jinchiyu/nove-macropad/kit/guides/macropad-full-schematic.png

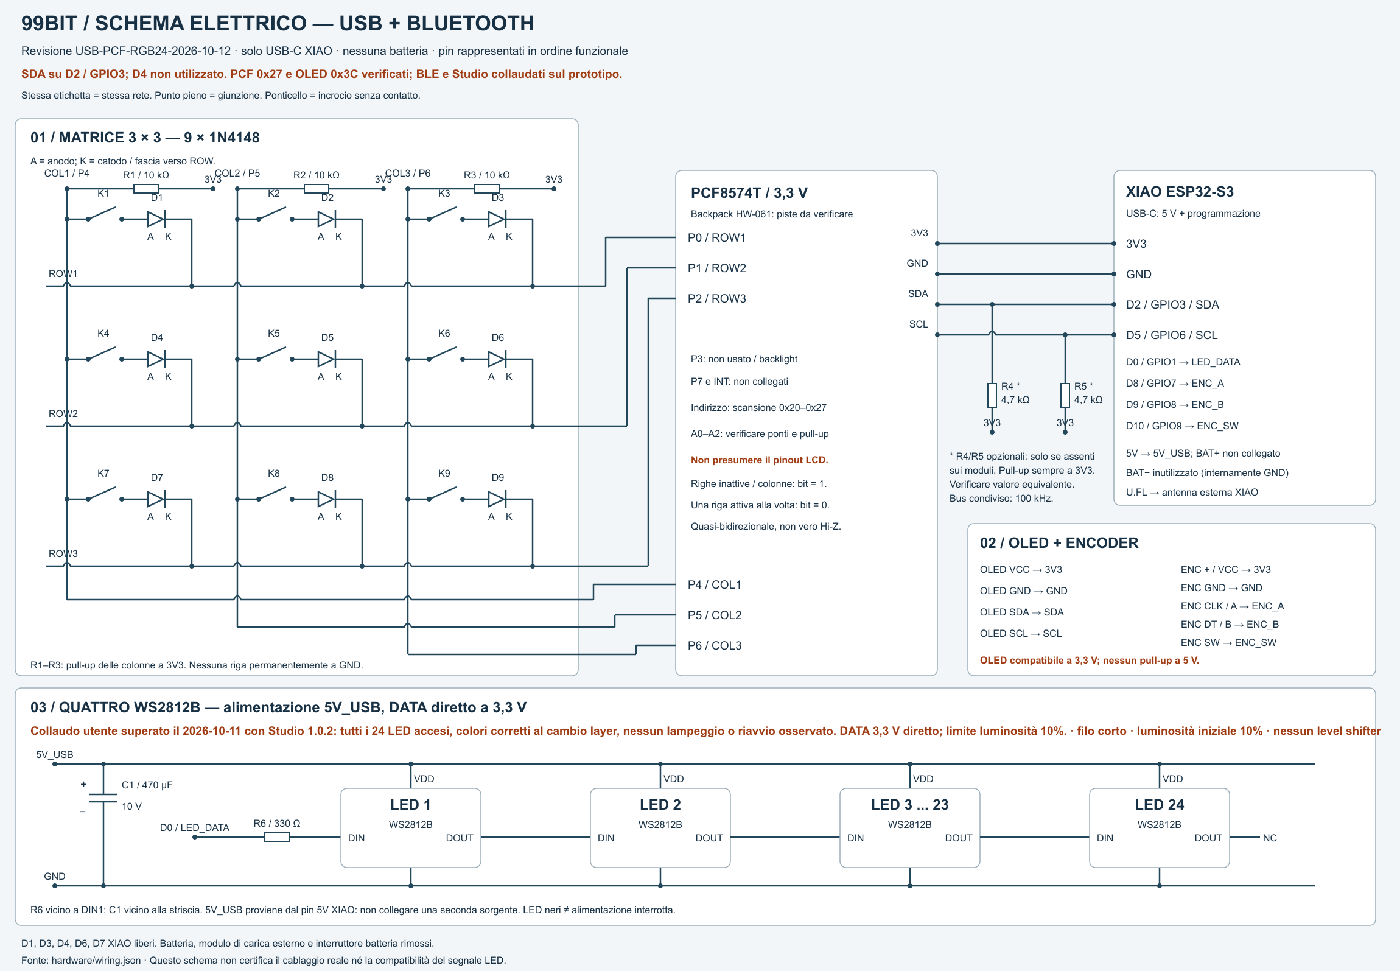
kit/guides/macropad-full-schematic.png
