jinchiyu/nove-macropad/kit/3MF/99BIT-V29-K1C-All-Plates.3mf

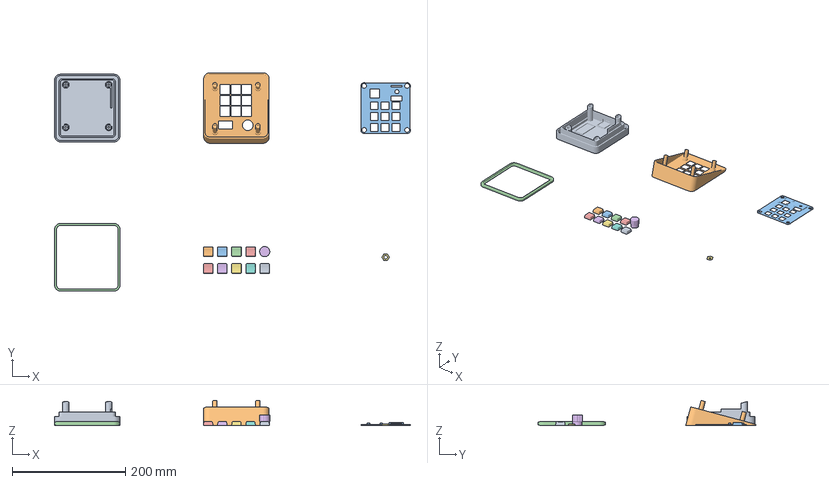
[picture p2: CAD file, 2026-10-12]
kit/3MF/99BIT-V29-K1C-All-Plates.3mf
630.0 x 386.4 x 44.6 mm
01-base.stl
02-shell.stl
03-control-plate.stl
04-diffuser.stl
05-keycap-1.stl
05-keycap-2.stl
05-keycap-3.stl
05-keycap-4.stl
05-keycap-5.stl
05-keycap-6.stl
05-keycap-7.stl
05-keycap-8.stl
05-keycap-9.stl
06-knob-extended.stl
07-encoder-nut.stl
