jinchiyu/nove-macropad/kit/3MF/02-shell-black.3mf

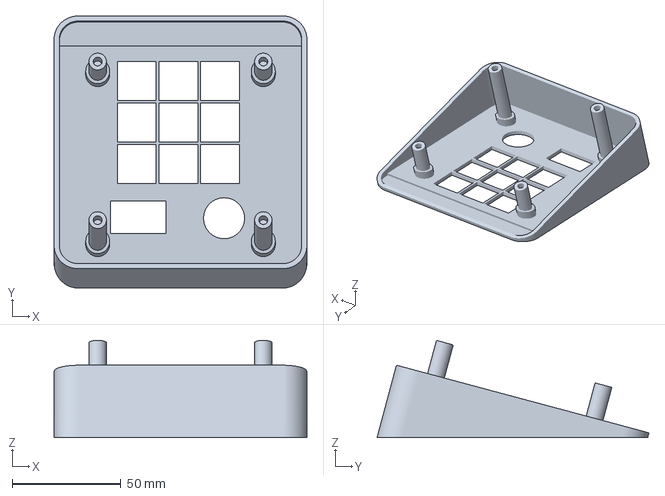
[picture p3: CAD file, 2026-10-12]
kit/3MF/02-shell-black.3mf
116.0 x 124.8 x 44.6 mm
