jinchiyu/nove-macropad/kit/STL/05-keycap-6.stl

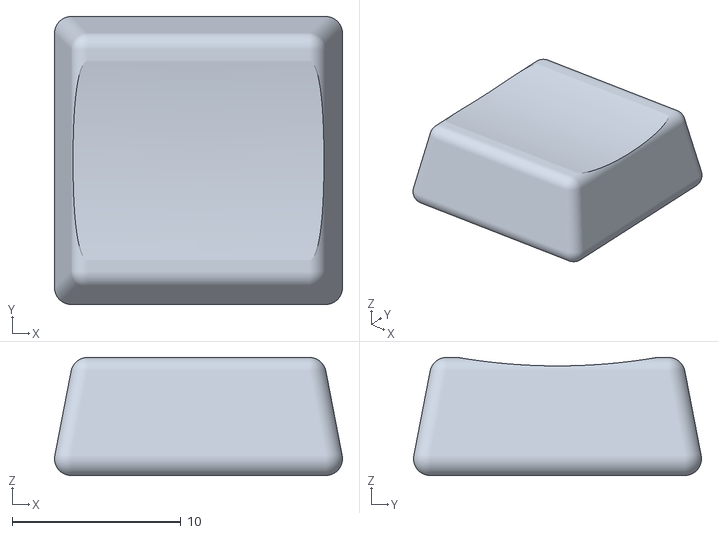
[picture p4: CAD file, 2026-10-12]
kit/STL/05-keycap-6.stl
17.1 x 17.1 x 7.00
