jinchiyu/nove-macropad/kit/3MF/05-keycaps-and-knob-translucent.3mf

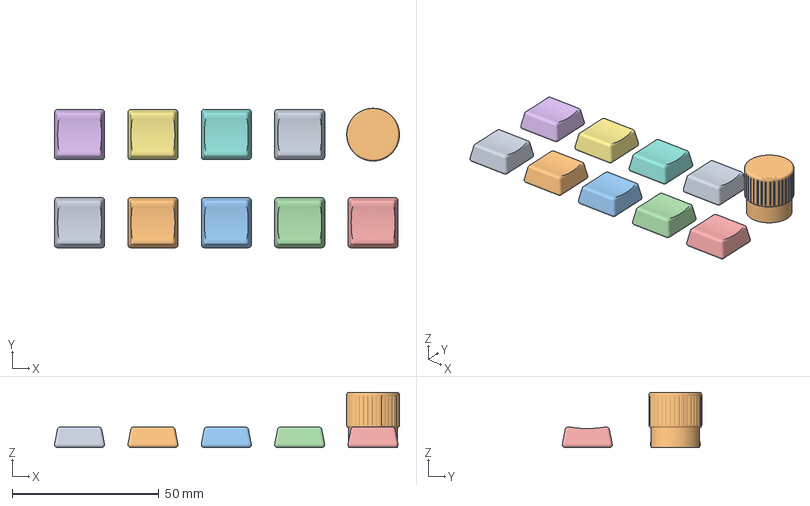
[picture p5: CAD file, 2026-10-12]
kit/3MF/05-keycaps-and-knob-translucent.3mf
117.5 x 47.5 x 18.8 mm
05-keycap-1.stl
05-keycap-2.stl
05-keycap-3.stl
05-keycap-4.stl
05-keycap-5.stl
05-keycap-6.stl
05-keycap-7.stl
05-keycap-8.stl
05-keycap-9.stl
06-knob-extended.stl
