jinchiyu/nove-macropad/kit/STL/01-base.stl

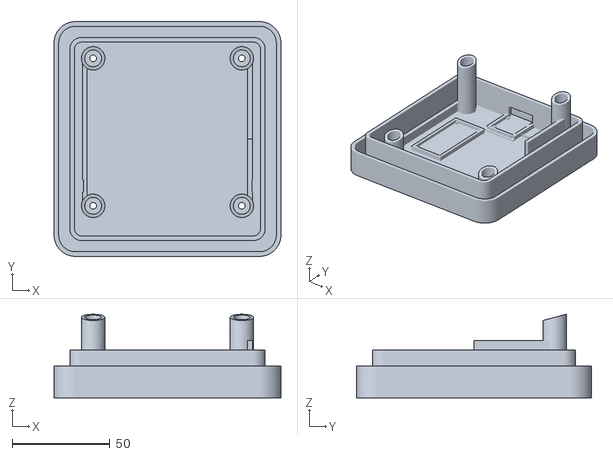
[picture p6: CAD file, 2026-10-12]
kit/STL/01-base.stl
116.0 x 120.0 x 42.7
