jinchiyu/nove-macropad/kit/3MF/03-control-plate-black.3mf

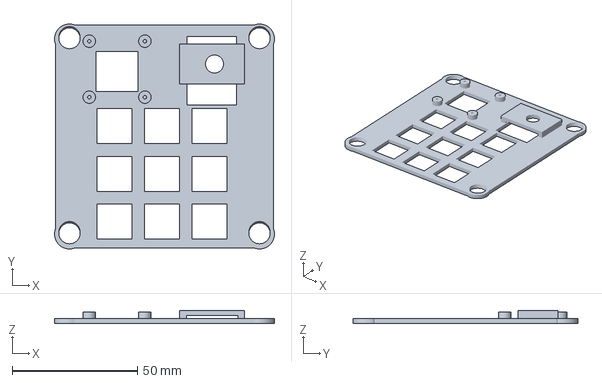
[picture p7: CAD file, 2026-10-12]
kit/3MF/03-control-plate-black.3mf
88.0 x 90.0 x 5.37 mm
