jinchiyu/nove-macropad/kit/3MF/04-diffuser-translucent.3mf

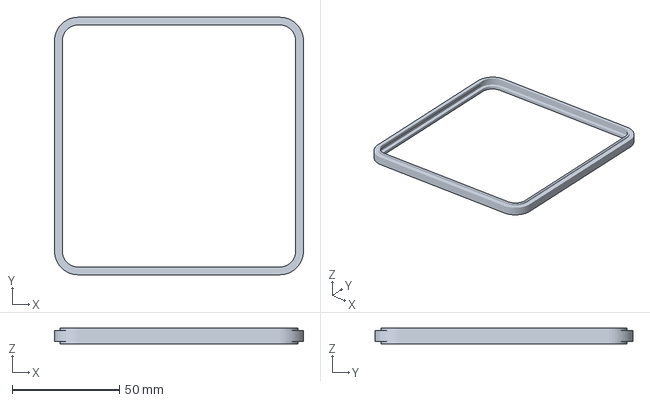
[picture p8: CAD file, 2026-10-12]
kit/3MF/04-diffuser-translucent.3mf
116.0 x 120.0 x 7.40 mm
