jinchiyu/nove-macropad/kit/STL/06-knob-extended.stl

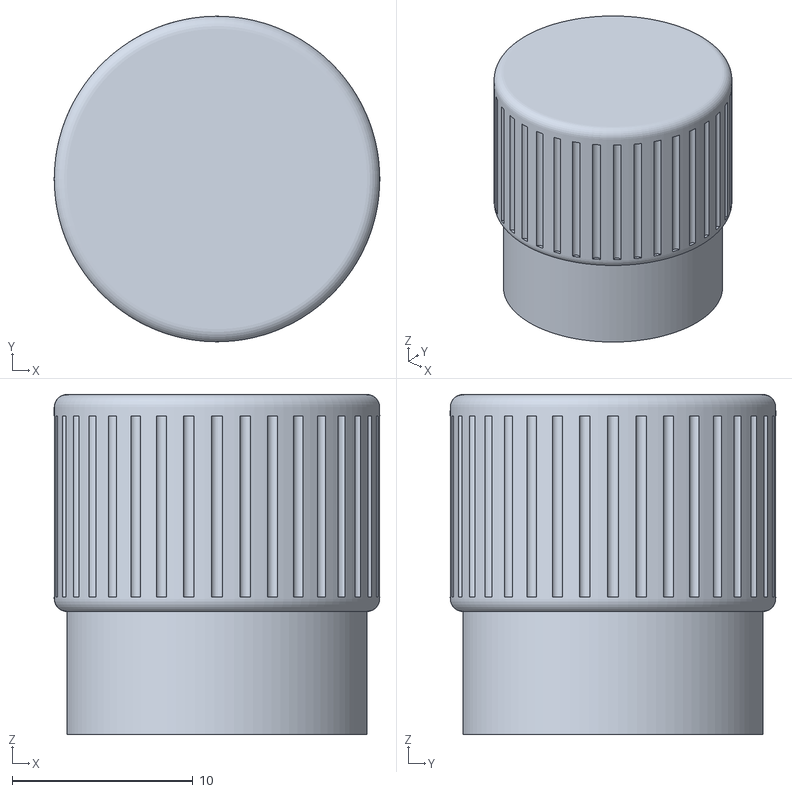
[picture p9: CAD file, 2026-10-12]
kit/STL/06-knob-extended.stl
18.0 x 18.0 x 18.8
