jinchiyu/nove-macropad/(list of files, cad)

Other CAD files:
kit/STL/05-keycap-7.stl
kit/STL/05-keycap-8.stl
kit/STL/05-keycap-9.stl
kit/3MF/01-base-black.3mf
kit/STL/03-control-plate.stl
kit/STL/05-keycap-4.stl
kit/STL/02-shell.stl
kit/STL/05-keycap-2.stl
kit/STL/04-diffuser.stl
kit/STL/05-keycap-5.stl
kit/STL/05-keycap-3.stl
kit/STL/05-keycap-1.stl
kit/3MF/06-encoder-nut-black.3mf
kit/STL/07-encoder-nut.stl
