jinchiyu/nove-macropad/kit/software/source/include/hid_reports.h

#pragma once
#include "core.h"
namespace hid {
// ID 1: standard 8-byte keyboard; ID 2: one 16-bit Consumer usage.
constexpr uint8_t kReportMap[] = {
    0x05, 0x01, 0x09, 0x06, 0xA1, 0x01, 0x85, 0x01, 0x05, 0x07, 0x19, 0xE0, 0x29, 0xE7, 0x15,
    0x00, 0x25, 0x01, 0x75, 0x01, 0x95, 0x08, 0x81, 0x02, 0x75, 0x08, 0x95, 0x01, 0x81, 0x01,
    0x05, 0x08, 0x19, 0x01, 0x29, 0x05, 0x75, 0x01, 0x95, 0x05, 0x91, 0x02, 0x75, 0x03, 0x95,
    0x01, 0x91, 0x01, 0x05, 0x07, 0x19, 0x00, 0x29, 0x65, 0x15, 0x00, 0x25, 0x65, 0x75, 0x08,
    0x95, 0x06, 0x81, 0x00, 0xC0, 0x05, 0x0C, 0x09, 0x01, 0xA1, 0x01, 0x85, 0x02, 0x15, 0x00,
    0x26, 0xFF, 0x03, 0x19, 0x00, 0x2A, 0xFF, 0x03, 0x75, 0x10, 0x95, 0x01, 0x81, 0x00, 0xC0};
inline void keyboard(const core::Action &action, uint8_t (&out)[8]) {
  for (auto &byte : out)
    byte = 0;
  out[0] = action.modifiers;
  out[2] = static_cast<uint8_t>(action.usage);
}
inline void consumer(const core::Action &action, uint8_t (&out)[2]) {
  out[0] = action.usage & 0xff;
  out[1] = action.usage >> 8;
}
} // namespace hid
